L1MOJ/Integration-of-Electrical-Circuit/(list of files, cad)

Other CAD files:
LCDtest/Objects/main.obj
main/main.OBJ
main/LCD1602.OBJ
LCDtest/Objects/LCD1602.obj
main/delay.OBJ
LCDtest/Objects/delay.obj
LCDtest/Objects/oled.obj
main/oled.OBJ
LCDtest/Objects/90614.obj
main/90614.OBJ
