L1MOJ/Integration-of-Electrical-Circuit/draft1.pdf

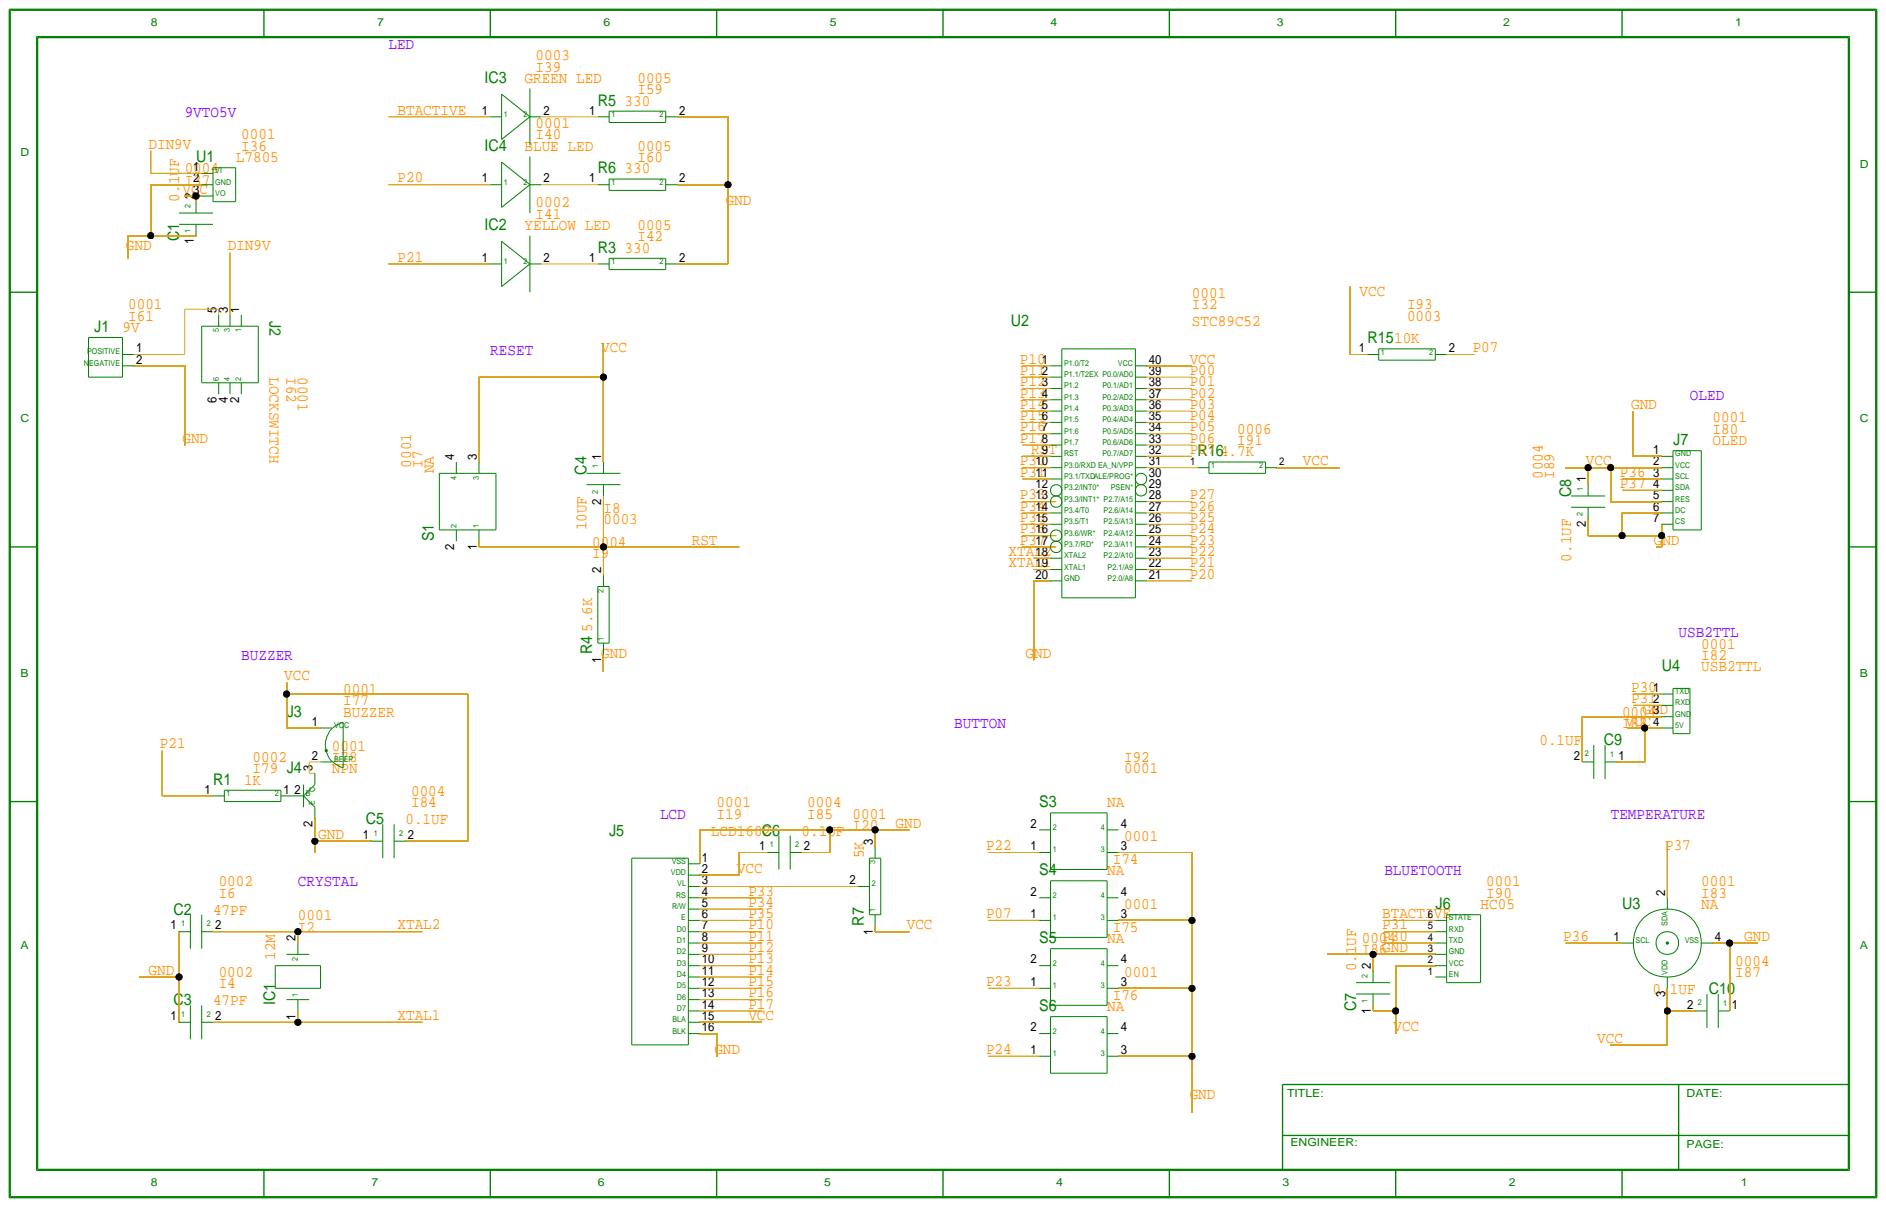
[picture p1: page 1]

TITLE: | DATE:

ENGINEER: | PAGE:
