L1MOJ/Integration-of-Electrical-Circuit/main/bmp.h

//////////////////////////////////////////////////////////////////////////////////	 
//嵌入式开发网
//mcudev.taobao.com
//  功能描述   : OLED 4接口演示例程(51系列)
//              说明: 
//              ----------------------------------------------------------------
//              GND    电源地
//              VCC  接5V或3.3v电源
//              D0   P1^0（SCL）
//              D1   P1^1（SDA）
//              RES  接P12
//              DC   接P13
//              CS   接P14               
//              ----------------------------------------------------------------
 
//******************************************************************************/

#ifndef __BMP_H
#define __BMP_H
unsigned char code BMP1[] =
{

0,255,255,255,255,255,255,255,255,255,255,255,255,255,255,255,255,255,255,255,255,255,255,255,255,255,255,255,239,207,207,199,135,135,135,7,7,7,15,15,15,15,15,31,31,31,31,63,63,63,63,63,127,127,127,127,255,255,255,255,255,255,255,255,255,255,255,255,255,255,255,255,255,127,127,127,127,63,63,63,63,63,31,31,31,31,31,15,15,15,15,7,7,7,135,135,135,199,207,207,239,255,255,255,255,255,255,255,255,255,255,255,255,255,255,255,255,255,255,255,255,255,255,255,255,255,255,255,
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
	0x00,0x00,0x00,0x00,0x00,0x00,0x00,0x00,0x00,0x00,0x00,0x00,0x00,0x00,0x00,0x00,
	0x00,0x00,0x00,0x00,0x00,0x40,0x20,0x20,0x20,0xC0,0x00,0x00,0xE0,0x20,0x20,0x20,
	0xE0,0x00,0x00,0x00,0x40,0xE0,0x00,0x00,0x00,0x00,0x60,0x20,0x20,0x20,0xE0,0x00,
	0x00,0x00,0x00,0x00,0xE0,0x20,0x20,0x20,0xE0,0x00,0x00,0x00,0x00,0x00,0x40,0x20,
	0x20,0x20,0xC0,0x00,0x00,0x40,0x20,0x20,0x20,0xC0,0x00,0x00,0x00,0x00,0x00,0x00,
	0x00,0x00,0x00,0x00,0x00,0x00,0x00,0x00,0x00,0x00,0x00,0x00,0x00,0x00,0x00,0x00,
	0x00,0x00,0x00,0x00,0x00,0x00,0x00,0x00,0x00,0x00,0x00,0x00,0x00,0x00,0x00,0x00,
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
	
#endif
